akarapon-oaksonsombat/wheel-drive-drawing-robot/README.md

# wheel-drive-drawing-robot
See more in [PSU CoE Project site](https://project.coe.psu.ac.th/projects/6236d625dbcc602776d4a9ff)
or using online tools on [Link](https://drawing-tools-akarapon.web.app/#/)
