akarapon-oaksonsombat/wheel-drive-drawing-robot/wheel_drive_drawing_robot.pdf

หุ่นยนต์วาดภาพขับเคลื่อนด้วยล้อ Wheel drive drawing robot.

อัครพล อักษรสมบัติ 6010110514 พบธรรม วราหกิจ 6110110306

โครงงานวิศวกรรมคอมพิวเตอร์นี้เป็นส่วนหนึ่งของการศึกษาตามหลักสูตร ปริญญาวิศวกรรมศาสตรบัณฑิต สาขาวิชาวิศวกรรมคอมพิวเตอร์ ภาควิชาวิศวกรรมคอมพิวเตอร์คณะวิศวกรรมศาสตร์ มหาวิทยาลัยสงขลานครินทร์
2564

ก

ชื่อโครงงาน | หุ่นยนต์วาดภาพขับเคลื่อนด้วยล้อ
ผู้จัดท า | นายอัครพล อักษรสมบัติ | รหัสนักศึกษา | 6010110514
| นายพบธรรม วราหกิจ | รหัสนักศึกษา | 6110110514
สาขาวิชา | วิศวกรรมคอมพิวเตอร์
ปีการศึกษา | 2564
อาจารย์ที่ปรึกษาโครงงาน | คณะกรรมการสอบ
| ( ผศ.ด ารงค์ เคล้าดี ) | | ( รศ.ดร.มนตรี กาญจนเดชะ )
| | ( ผศ.ดร.วชรินทร์ แก้วอภิชัย )

โครงงานนี้เป็นส่วนหนึ่งของรายวิชาโครงงานวิศวกรรมคอมพิวเตอร์ 1 และ 2 ตามหลักสูตร ปริญญาวิศวกรรมศาสตรบัณฑิต สาขาวิชาวิศวกรรมคอมพิวเตอร์ มหาวิทยาลัยสงขลานครินทร์

| | ( ผศ.ดร.นิคม สุวรรณวร ) หัวหน้าสาขาวิชาวิศวกรรมคอมพิวเตอร์

ข

หนังสือรับรองความเป็นเอกลักษณ์ ข้าพเจ้าผู้ลงนามท้ายนี้ ขอรับรองว่ารายงานฉบับนี้เป็นรายงานที่มีความเป็นเอกลักษณ์ โดยที่ ข้าพเจ้ามิได้มีการคัดลอกมาจากที่ใด เนื้อหาในรายงานทั้งหมดถูกรวบรวมจากการพัฒนาในขั้นตอน ต่าง ๆ ของการจัดท าโครงงาน หากมีส่วนใดที่จ าเป็นต้องน าข้อความจากผลงานของบุคคลอื่นใดที่ ไม ่ใช ่ตัวข้าพเจ้า ข้าพเจ้าได้ท าการอ้างอิงถึงเอกสารเหล ่านั้นไว้อย ่างเหมาะสม และขอรับรองว่า รายงานฉบับนี้ไม่เคยเสนอต่อสถาบันใดมาก่อน

ผู้จัดท า

(นายอัครพล อักษรสมบัติ)
(นายพบธรรม วราหกิจ)

ค

ชื่อโครงงาน | หุ่นยนต์วาดภาพขับเคลื่อนด้วยล้อ
ผู้จัดท า | นายอัครพล อักษรสมบัติ | รหัสนักศึกษา | 6010110514
| นายพบธรรม วราหกิจ | รหัสนักศึกษา | 6110110306
สาขาวิชา | วิศวกรรมคอมพิวเตอร์
ปีการศึกษา | 2564

บทคัดย่อ
โครงงานฉบับนี้มีวัตถุประสงค์เพื ่อออกแบบและพัฒนาหุ ่นยนต์วาดภาพ 2 มิติโดยการ ขับเคลื่อนด้วยล้อ โดยแบ่งออกเป็น 3 ส่วน คือ ระบบกลไก ระบบอิเล็กทรอนิกส์และซอฟต์แวร์และ อัลกอริทึมในการท างานโดยใช้ระบบพิกัดฉากในการสั่งงานวาดภาพและรองรับข้อมูลพิกัดที่แปลงมา จากข้อมูลในรูปแบบ Gcode โดยใช้บอร์ดไมโครคอนโทรลเลอร์ Arduino ในการควบคุมการท างาน ของระบบพร้อมทั้งสามารถจ าลองผลการวาดภาพก่อนวาดจริงผ่านหน้าเว็บแอพพลิเคชันที่พัฒนาขึ้น

ค าส าคัญ ระบบขับเคลื่อนด้วยล้อ หุ่นยนต์วาดภาพสองมิติ การจ าลองการวาดภาพจาก Gcode

ง

Project | 2D Drawing Robotic Arm Driven by Wheels.
Author | Mr.Akarapon Oaksonsombat | Student ID | 6010110514
| Mr.Phobthum Varahakij | Student ID | 6110110306

Major Program Computer Engineering

Academic Year 2021

Abstract
This project aims to design and develop a wheel drive drawing robot. It is divided into 3 parts which are mechanical system, electronic system and software and working algorithm by using scene coordinate system to order drawing and support coordinate data converted from data in Gcode format using a microcontroller board. Arduino to control the operation of the system and can simulate the drawing results before the actual drawing through the web application developed.

Keyword Wheel Drive, Wheel drive drawing Robot, Gcode Drawing Simulator

จ

กิตติกรรมประกาศ

โครงงานเรื่อง “แขนกลวาดภาพ 2 มิติโดยการขับเคลื่อนด้วยล้อ” สามารถด าเนินการบรรลุ ตามเป้าหมายในทุกขั้นตอน ตั้งแต ่การศึกษาหาข้อมูล การด าเนินการต ่าง ๆ รวมไปถึงการจัดท า รายงานฉบับนี้ให้ส าเร็จลุล่วงไปได้ด้วยดี เนื่องจากได้รับความดูแลเอาใจใส่และความเอื้อเฟื้อจาก ผศ.ด ารงค์ เคล้าดี อาจารย์ที่ปรึกษาโครงงาน ซึ่งได้ให้ค าแนะน าและข้อคิดเห็นต่าง ๆ รวมถึงแก้ไข ปัญหาที่เกิดขึ้นในระหว่างการด าเนินงาน และต้องขอขอบคุณไปถึง รศ.ดร.มนตรี กาญจนะเดชะ, ดร.วชรินทร์แก้วอภิชัย, ผศ.ดร.ทวีศักดิ์ เรืองพีระกุล คณะกรรมการสอบที่ให้ข้อเสนอแนะเพื ่อให้ ผู้จัดท าน ามาปรับปรุงแก้ไข
ขอขอบคุณคณะวิศวกรรมศาสตร์ มหาวิทยาลัยสงขลานครินทร์ที่ช่วยสนับสนุนเงินเพื่อใช้ใน การท าโครงงาน

อัครพล อักษรสมบัติ
พบธรรม วราหกิจ

ฉ

สารบัญ
บทคัดย่อ | ค
Abstract | ง
กิตติกรรมประกาศ | จ
สารบัญ | ฉ
รายการภาพประกอบ | ฌ
รายการตาราง | ญ

ช

ซ

ฌ

รายการภาพประกอบ

ญ

รูปที่ 4-26 ค าสั่งที่ใช้ในการรับข้อมูลจากการป้อนจาก Analog Buttonแล้วแสดงผลในจอ LCD....32

รูปที่ 4-30 ภาพถ่ายการแสดงผลตามฟังก์ชันแสดงผลหน้าจอควบคุมการท างานแบบก าหนดเอง....35

รายการตาราง

ฎ

บทที่1 บทน า

### 1.1 ที่มาและความส าคัญ

หุ่นยนต์เป็นหุ่นยนต์ชนิดหนึ่งที่น ามาใช้งานแทนแรงงานมนุษย์โดยมักถูกใช้ในงานที่ต้องท าซ ้า ๆ และต้องการความแม่นย าสูง ซึ่งต้นทุนในการประดิษฐ์หุ ่นยนต์นั้นมีราคาค่อนข้างสูงและเป็นที่ ต้องการอย่างมากในอุตสาหกรรมการผลิตต่าง ๆ ในปัจจุบัน
หุ ่นยนต์วาดภาพเป็นหนึ ่งรูปแบบของหุ ่นยนต์ที ่ถูกออกแบบมาให้มีความสามารถแบบ เฉพาะเจาะจงในการวาดภาพและสามารถใช้ประกอบการศึกษากลไกการขับเคลื่อนของหุ่นยนต์ผ่าน การแสดงออกในรูปแบบของลายเส้นที่เป็นผลลัพธ์จากการท างานของหุ่นยนต์อีกด้วย การใช้ระบบขับเคลื่อนด้วยล้อท าให้ชิ้นงานมีความสามารถในการเคลื่อนหรือหมุนไปตามทิศ ต่าง ๆ ได้ซึ่งท าให้สามารถลดต้นทุนในการประดิษฐ์หุ่นยนต์วาดภาพโดยยังคงความสามารถในการ ท างานไว้ได้อย่างครบถ้วน
ผู้จัดท าจึงยกประเด็นนี้มาเป็นหัวข้อในการท าโครงงานเพื่อออกแบบและพัฒนาหุ่นยนต์วาด ภาพสองมิติที่ใช้กลไกการขับเคลื่อนด้วยล้อส าหรับใช้ในการศึกษาอัลกอริทึมและกลไกการท างานของ หุ่นยนต์รูปแบบนี้ในอนาคตโดยมีหลักการในการพัฒนาคือตัวชิ้นงานจะต้องมีความเรียบง่ายและใช้ ต้นทุนต ่า

### 1.2 วัตถุประสงค์

1. เพื่อออกแบบหุ่นยนต์วาดภาพสองมิติที่ใช้กลไกการขับเคลื่อนด้วยล้อ
2. สร้างองค์ความรู้พื้นฐานเกี่ยวกับระบบขับเคลื่อนในสองมิติด้วยล้อ

### 1.3 ประโยชน์ที่คาดว่าจะได้รับ

1. ได้หุ่นยนต์ขับเคลื่อนในสองมิติด้วยล้ออย่างง่ายและมีต้นทุนในการประดิษฐ์ที่ถูกและง่าย ต่อการพัฒนาต่อยอด
2. ได้องค์ความรู้พื้นฐานเกี่ยวกับระบบขับเคลื่อนด้วยล้อที่ควบคุมด้วยไมโครคอนโทรลเลอร์
3. ผลงานที่ถูกสร้างและพัฒนาขึ้นนี้สามารถใช้เป็นต้นแบบในการศึกษาและพัฒนาต่อยอด เพื่อเป็นประโยชน์ในอนาคตได้

### 1.4 ขอบเขตของโครงงาน

1. หุ่นยนต์ที่พัฒนาจะวาดชิ้นงานแบบสองมิติโดยใช้การขับเคลื่อนด้วยล้อ
2. หุ่นยนต์ที่พัฒนาจะสามารถวาดภาพในพื้นที่ขนาดอย่างน้อย 4 ตารางเซนติเมตร

### 1.5 ขั้นตอนการด าเนินงาน

1. ศึกษาทฤษฎีเกี่ยวกับแขนหุ่นยนต์
2. ศึกษาการท างานและการใช้งาน Stepping Motor
3. ศึกษาระบบอิเล็กทรอนิกส์ด้านการแสดงผลและการเชื่อมต่อผู้ใช้
4. ศึกษาอัลกอริทึมและการควบคุมของระบบ
5. ออกแบบโครงสร้างทางกลไก
6. ออกแบบระบบอิเล็กทรอนิกส์
7. ออกแบบอัลกอริทึมและซอฟต์แวร์ควบคุมระบบ
8. ทดสอบการใช้งานอุปกรณ์ฮาร์ดแวร์
9. พัฒนาซอฟต์แวร์ที่ใช้ในการควบคุมการท างานแต่ละส่วน
10. น าซอฟต์แวร์ที่พัฒนามาประกอบเข้ากันเป็นระบบ
11. ทดสอบการท างานขั้นต้นของระบบ
12. ทดสอบการท างานจริงของทั้งระบบ
13. ท าการปรับปรุงแก้ไขข้อผิดพลาดที่ได้จากการทดสอบ
14. จัดท ารายงานฉบับสมบูรณ์

บทที่2 ทฤษฎีและหลักการ

เพื่อให้การด าเนินงานบรรลุตามวัตถุประสงค์ผู้จัดท าจึงได้ท าการศึกษาทฤษฎีและหลักการต่าง ๆ เพื่อเป็นองค์ความรู้ประกอบการพัฒนาระบบซึ่งแบ่งศึกษาออกเป็นสามส่วนคือ ส่วนระบบทางกลไก ส่วนระบบอิเล็กทรอนิกส์และส่วนซอฟต์แวร์และอัลกอริทึม
ส ่วนระบบทางกลไกได้ท าการศึกษากลไกของแขนหุ ่นยนต์ [1] ระบบขับเคลื ่อนด้วยล้อและ มอเตอร์ซึ่งมีรายละเอียดการศึกษาดังนี้

### 2.1 แขนหุ่นยนต์

แขนหุ่นยนต์[2] เป็นชนิดของหุ่นยนต์ที่มีการเคลื่อนไหวในแบบที่เป็นไปในลักษณะเชิงกลไกที่มัก ถูกใช้ส าหรับหยิบ จับ เคลื่อนย้ายสิ่งของได้ในพื้นที่การท างาน หรือ Working Space ที่ก าหนดไว้ เท่านั้น โดยมีองค์ประกอบดังต่อไปนี้

### 2.1.1 Degree of Freedom

Degree of Freedom (DoF) หรือ องศาอิสระ คือ จ านวนแกนหรือทิศทางที ่แขนหุ ่นยนต์ สามารถเคลื ่อนไหวได้ ซึ ่งแบ ่งการเรียกตามลักษณะความสามารถในการเคลื ่อนไหว คือ การ เคลื่อนไหวในแนวระนาบและไม่สามารถปรับมุมการหมุนได้ เรียกว่า “2 Degree of Freedom” การ เคลื ่อนไหวในสามมิติแต ่ไม ่สามารถปรับมุมการเอียงของปลายแขนได้ เรียกว ่า “3 Degree of Freedom” และการเคลื่อนไหวในสามมิติและสามารถควบคุมการหมุนของปลายแขนได้รอบทิศทาง ซึ่งเรียกว่า “6 Degree of Freedom”
ส าหรับหุ่นยนต์ที่มีมากกว่า 6 Degree of Freedom คือ หุ่นยนต์ที่สามารถเคลื่อนปลายแขนไป ยังต าแหน่งใด ๆ ในสามมิติและสามารถควบคุมการหมุนของปลายแขนได้มากกว่า 1 ท่าทางเพื่อให้ได้ ต าแหน่งปลายแขนอยู่ในต าแหน่งเดิม เช่น กรณีของแขนมนุษย์ทั่วไปซึ่งจะมี 7 Degree of Freedom ซึ่งสามารถขยับแขนได้โดยที่มืออยู่ในต าแหน่งเดิม

### 2.1.2 Working Space

Working Space หรือ พื้นที่การท างาน คือ พื้นที่ที่ปลายของแขนหุ่นยนต์สามารถเคลื่อนที่ไปได้

### 2.1.3 Link

Link หรือ ลิงค์คือ โครงสร้างแขนแต่ละท่อนของแขนหุ่นยนต์

### 2.1.4 Base

Base หรือ ฐาน คือ ลิงค์ชั้นแรกสุดที่ใช้ยึดแขนหุ่นยนต์ไว้กับพื้น

### 2.1.5 Joint

Joint หรือ ข้อต่อ คือ ส่วนเชื่อมต่อระหว่างแต่ละลิงค์ของแขนหุ่นยนต์แบ่งเป็น 2 ประเภท คือ
1. Active Joint
Active Joint คือ ข้อต่อที่มีต้นก าลังติดตั้งอยู่ท าให้สามารถควบคุมการเคลื่อนที่ได้
2. Passive Joint
Passive Joint คือ ข้อต่อที่ไม่มีต้นก าลังติดตั้งอยู่ท าให้ไม่สามารถควบคุมการเคลื่อนที่ได้ โดยการเคลื่อนที่ของ Passive Joint จะเป็นไปตามการเคลื่อนที่ของข้อต่ออื่น ๆ ที่เชื่อมโยง กันและแบ่งออกตามรูปแบบการเคลื่อนที่ได้ 4 รูปแบบ คือ
- Revolute Joint คือ ข้อต่อที่หมุนได้ (1 DoF)
- Prismatic Joint คือ ข้อต่อที่เคลื่อนที่เข้า-ออกเป็นแนวเส้น (1 DoF)
- Screw Joint คือ ข้อต่อที่หมุนและเคลื่อนที่เข้า-ออกสัมพันธ์กัน (1 DoF)
- Spherical Joint คือ ข้อต่อที่หมุนได้รอบ (2 DoF)

### 2.1.6 Wrist

Wrist คือ ข้อต่อที่ไม่ท าให้เกิดการเคลื่อนที่ในสามมิติแต่ท าให้เกิดการหมุนมักไว้เป็นข้อต่อสุดท้าย ที่ปลายแขน

### 2.1.7 End Effector

End-Effector คือ อุปกรณ์ที่ติดตั้งไว้ที่ปลายแขนเพื่อใช้ท างาน โดยอาจเป็นมือจับ ตัวดูด สุญญากาศ สว่าน เป็นต้น

แขนหุ่นยนต์ที่ใช้ในอุตสาหกรรมแบ่งออกเป็น 5 ประเภทตามลักษณะการเคลื่อนไหวดังตารางที่ 2-1Error! Reference source not found.

5

ตารางที่ 2-1 ประเภทของแขนหุ่นยนต์

ประเภทของแขนหุ่นยนต์[3] | ข้อดี - ข้อเสีย | การประยุกต์ใช้งาน
Cartesian Robot | ข้อดี เคลื่อนที่เป็นแนวเส้นตรงทั้ง 3 มิติสามารถท าความเข้าใจการเคลื่อนที่ได้ ง่ายและมีส่วนประกอบน้อยอีกทั้งโครงสร้างยังมั่นคงตลอดการเคลื่อนที่ ข้อเสีย ต้องการพื้นที่ติดตั้งมากและบริเวณที่หุ ่นยนต์เข้าไปท างานได้จะต้องมี ขนาดเล็กกว่าขนาดของตัวหุ่นยนต์อีกทั้งไม่สามารถเข้าถึงวัตถุจากทิศทาง ข้างใต้ได้และยังแกนแบบเชิงเส้นป้องกันฝุ่นและของเหลวได้ยากอีกด้วย

เนื่องจากโครงสร้างมีความแข็งแรงตลอดแนวการ เคลื่อนที่ ดังนั้นจึงเหมาะกับงานเคลื่อนย้ายของหนัก ๆ หรือเรียกว ่างาน Pick-and-Place เช ่นใช้โหลด ชิ้นงานเข้าเครื่องจักร (Machine loading) ใช้จัดเก็บ ชิ้นงาน (Stacking) นอกจากนี้ยังสามารถใช้ในงาน ประกอบ (Assembly) ที่ไม่ต้องการเข้าถึงในลักษณะ ที่มีมุมหมุน เช่น ประกอบอุปกรณ์อิเล็กทรอนิกส์ และ งาน Test ต่าง ๆ

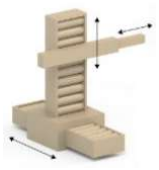
[picture p1: figure]

Cylindrical Robot | ข้อดี ตัวหุ่นยนต์มีส่วนประกอบไม่ซับซ้อนและมีการเคลื่อนที่สามารถเข้าใจได้ ง่าย สามารถเข้าถึงเครื่องจักรที่มีการเปิด-ปิด หรือเข้าไปในบริเวณที่เป็น ช่องหรือโพรงได้ง่าย (Loading) เช่น การโหลดชิ้นงานเข้าเครื่อง CNC

โดยทั ่วไปจะใช้ในการหยิบยกชิ้นงาน หรือ ป้อนชิ้นงานเข้าเครื่องจักร เพราะสามารถเคลื่อนที่เข้า ออกบริเวณที่เป็นช่องโพรงเล็ก ๆ ได้สะดวก

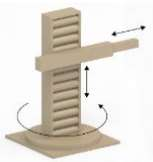
[picture p2: figure]

6

ประเภทของแขนหุ่นยนต์[3] | ข้อดี - ข้อเสีย | การประยุกต์ใช้งาน
| ข้อเสีย มีพื้นที่ท างานจ ากัดและยังแกนแบบเชิงเส้นป้องกันฝุ่นและของเหลวได้ ยากอีกด้วย

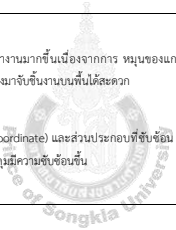
[picture p3: figure]

Spherical Robot | ข้อดี หุ ่นยนต์มีปริมาตรการท างานมากขึ้นเนื ่องจากการ หมุนของแกนที ่ 2 (ไหล่) และสามารถที่จะก้มลงมาจับชิ้นงานบนพื้นได้สะดวก ข้อเสีย หุ่นยนต์มีระบบพิกัด (Coordinate) และส่วนประกอบที่ซับซ้อน ท าให้ การเคลื่อนที่และระบบควบคุมมีความซับซ้อนขึ้น

ใช้ในงานที่มีการเคลื่อนที่ในแนวตั้ง (Vertical) เพียง เล็กน้อย เช่น การโหลดชิ้นงานเข้าออกจากเครื ่องปั๊ม (Press) หรืออาจจะใช้งานเชื่อมจุด (Spot Welding)

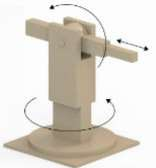
[picture p4: figure]

7

ประเภทของแขนหุ่นยนต์[3] | ข้อดี - ข้อเสีย | การประยุกต์ใช้งาน
SCARA Robot | ข้อดี หุ่นยนต์สามารถเคลื ่อนที ่ในแนวระนาบและขึ้นลงได้รวดเร็วด้วยความ แม่นย าสูง ข้อเสีย หุ่นยนต์มีพื้นที่ท างานจ ากัดและไม่สามารถหมุน (rotation) ในลักษณะ มุมต่าง ๆ ได้อีกทั้งสามารถยกน ้าหนัก (Payload) ได้ไม่มากนัก | เนื่องจากการเคลื ่อนที่ในแนวระนาบและขึ้นลงได้ รวดเร็วจึงเหมาะกับ งานประกอบชิ้นส ่วนทาง อิเล็กทรอนิกส์ซึ ่ง ต้องการความรวดเร็วและการ เคลื่อนที่ก็ไม่ต้องการ การหมุนมากนัก แต่จะไม่เหมาะ กับงาน

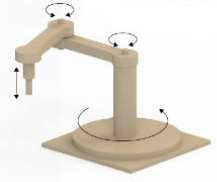
[picture p5: figure]

Articulated Arm
(Revolute)

ข้อดี
หุ่นยนต์สามารถเคลื ่อนที ่ในแนวระนาบและขึ้นลงได้รวดเร็วด้วยความ แม่นย าสูง
ข้อเสีย
หุ่นยนต์มีพื้นที่ท างานจ ากัดและไม่สามารถหมุน (rotation)ในลักษณะมุม ต่าง ๆ ได้อีกทั้งสามารถยกน ้าหนัก (Payload) ได้ไม่มากนัก

เนื่องจากการเคลื ่อนที่ในแนวระนาบและขึ้นลงได้ รวดเร็วจึงเหมาะกับ งานประกอบชิ้นส ่วนทาง อิเล็กทรอนิกส์ซึ ่ง ต้องการความรวดเร็วและการ เคลื่อนที่ก็ไม่ต้องการ การหมุนมากนัก แต่จะไม่เหมาะ กับงานประกอบชิ้นส ่วนทางกล (Mechanical part) ซ ึ ่งส ่ วนใหญ ่ก า รป ร ะกอบจ ะอ าศัย ก า รหมุน (Rotation) ในลักษณะมุมต ่าง ๆ นอกจากนี้ SCARA Robot ยังเหมาะกับงานตรวจสอบ (Inspection) งาน บรรจุภัณฑ์ (Packaging)

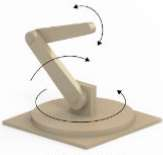
[picture p6: figure]

### 2.2 ระบบวาดภาพโดยใช้กลไกการขับเคลื่อนด้วยล้อ [1]

ผู้จัดท าได้ท าการศึกษาระบบวาดภาพโดยใช้กลไกการขับเคลื่อนด้วยล้อใน 4 รูปแบบดังนี้

### 2.2.1 ระบบวาดภาพโดยใช้กลไกการขับเคลื่อนด้วยล้อแบบคว ่า

ระบบวาดภาพโดยใช้กลไกการขับเคลื ่อนด้วยล้อแบบคว ่าจะเป็นการน าตัวขับเคลื ่อนวางทับ ชิ้นงานโดยจะมีกลไกการลดแรงเสียดทานอยู่ล่างชิ้นงานเพื่อให้ชิ้นงานสามารถเคลื่อนที่ได้

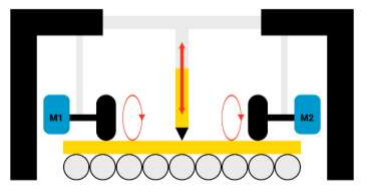
[picture p7: figure]

รูปที่ 2-1 ระบบวาดภาพโดยใช้กลไกการขับเคลื่อนด้วยล้อแบบคว ่า

### 2.2.2 ระบบวาดภาพโดยใช้กลไกการขับเคลื่อนด้วยล้อแบบหงาย

ระบบวาดภาพโดยใช้กลไกการขับเคลื ่อนด้วยล้อแบบหงาย เป็นการน าแผ ่นเรียบวางในแนว ระนาบไว้บนล้อที่ขับเคลื่อนด้วยมอเตอร์ ซึ่งอาจมีการติดตั้งล้อกลมในจุดต่าง ๆ ใต้แผ่นเรียบส าหรับ การช่วยพยุงแผ่นเรียบตามความเหมาะสม

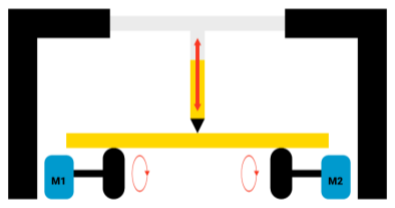
[picture p8: figure]

รูปที่ 2-2 ระบบวาดภาพโดยใช้กลไกการขับเคลื่อนด้วยล้อแบบหงาย

### 2.2.3 ระบบวาดภาพโดยใช้กลไกการขับเคลื่อนด้วยยานยนต์

ระบบวาดภาพโดยใช้กลไกการขับเคลื่อนด้วยยานยนต์จะอยู่ในรูปแบบคล้ายกับรถที่รวมอุปกรณ์ ส าหรับการท างานต่าง ๆ ไว้ โดยชิ้นงานจะอยู่กับที่

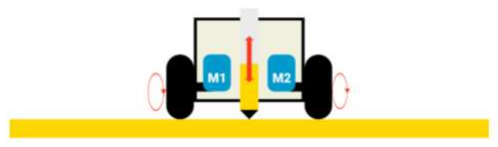
[picture p9: figure]

รูปที่ 2-3 ระบบวาดภาพโดยใช้กลไกการขับเคลื่อนด้วยยานยนต์

### 2.2.4 ระบบวาดภาพโดยใช้กลไกการขับเคลื่อนด้วยล้อแนวดิ่ง

ระบบวาดภาพโดยใช้กลไกการขับเคลื่อนด้วยล้อแนวดิ่งจะใช้หลักการเดียวกันกับระบบวาดภาพ โดยใช้กลไกการขับเคลื่อนด้วยยานยนต์แต่ตัวรถจะถูกติดตั้งไว้ที่ปลายแขนหุ่นยนต์และถูกกดไว้ให้ติด กับผนัง โดยการท างานของแขนหุ่นยนต์นั้นจะมีหน้าที่เพียงกดและพยุงให้รถอยู่ติดกับผนัง

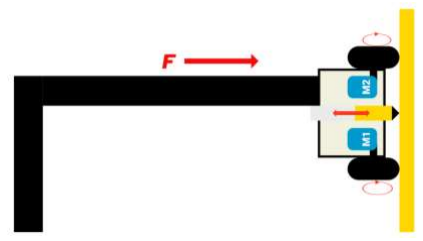
[picture p10: figure]

รูปที่ 2-4 ระบบวาดภาพโดยใช้กลไกการขับเคลื่อนด้วยล้อแนวแนวดิ่ง

### 2.3 มอเตอร์

มอเตอร์ที ่ใช้ในการท าโครงงานนี้มี 2 ชนิด คือ Stepping Motor และ Servo Motor ซึ ่งมี รายละเอียดการท างานดังนี้

### 2.3.1 Stepping Motor

Stepping Motor [4] เป็นมอเตอร์ไฟฟ้าที ่ขับเคลื ่อนด้วยสัญญาณแบบพัลส์โดยจะต้องจ ่าย สัญญาณพัลส์เป็นสเต็ปโดยขนาดของแต่ละสเต็ปจะขึ้นอยู่กับโครงสร้างของมอเตอร์ซึ่งสามารถหมุนได้ ทั้งสองทิศทางและไม่มีการจ ากัดรอบการหมุน

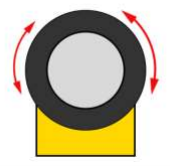
[picture p11: figure]

รูปที่ 2-5 ทิศทางการหมุนของ Stepping Motor การควบคุม Stepping Motor แบ ่งออกเป็นสามรูปแบบ คือ Full-Step 1 Phase Full-
Step 2 Phase และ Half-Step โดยมีลักษณะการจ่ายสัญญาณดังError! Reference source not found. ตารางที่ 2-3 และตารางที่ 2-4 ตามล าดับ

ตารางที่ 2-2 การควบคุม Stepping Motor ด้วยสัญญาณพัลส์แบบ Full-Step 1 Phase

สเต็ปที่ | เฟสที่ 1 | เฟสที่ 2 | เฟสที่ 3 | เฟสที่ 4
1 | 1 | 0 | 0 | 0
2 | 0 | 1 | 0 | 0
3 | 0 | 0 | 1 | 0
4 | 0 | 0 | 0 | 1

ตารางที่ 2-3 การควบคุม Stepping Motor ด้วยสัญญานพัลส์แบบ Full-Step 2 Phase

สเต็ปที่ | เฟสที่ 1 | เฟสที่ 2 | เฟสที่ 3 | เฟสที่ 4
1 | 1 | 1 | 0 | 0
2 | 0 | 1 | 1 | 0
3 | 0 | 0 | 1 | 1
4 | 1 | 0 | 0 | 1

ตารางที่ 2-4 การควบคุม Stepping Motor ด้วยสัญญาณพัลส์แบบ Half-Step

สเต็ปที่ | เฟสที่ 1 | เฟสที่ 2 | เฟสที่ 3 | เฟสที่ 4
1 | 1 | 0 | 0 | 0
2 | 1 | 1 | 0 | 0
3 | 0 | 1 | 0 | 0
4 | 0 | 1 | 1 | 0
5 | 0 | 0 | 1 | 0
6 | 0 | 0 | 1 | 1
7 | 0 | 0 | 0 | 1
8 | 1 | 0 | 0 | 1

ในการใช้งานจริงบอร์ดไมโครคอนโทรลเลอร์จะจ่ายไฟฟ้าได้ไม่เพียงพอในการขับการท างาน ของ Stepping Motor จึงมีความจ าเป็นในการใช้ Stepping Motor Driver ในการช่วยขับไฟฟ้าให้ เพียงพอส าหรับการท างานของ Stepping Motor

### 2.3.2 RC Servo Motor

RC Servo Motor เป็นมอเตอร์ที่สามารถรับค่าองศาเพื่อให้มอเตอร์หมุนไปยังองศาที่ก าหนดได้ ระหว่าง 0 ถึง 180 องศาและไม่สามารถหมุนเกินขอบเขตที่จ ากัดไว้ได้

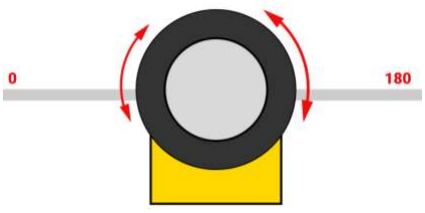
[picture p12: figure]

รูปที่ 2-6 ทิศทางการหมุนของ RC Servo Motor การควบคุมการท างานของ RC Servo Motor สามารถท าได้ง่ายผ่านไลบรารี Servo.h ซึ่งมี ให้ใช้งานใน Arduino IDE และจ่ายสัญญาณควบคุมโดยใช้ช่องเชื่อมต่อเดียว

ส่วนระบบอิเล็กทรอนิกส์ได้ท าการศึกษาการใช้งานอุปกรณ์ส าหรับการประดิษฐ์กล่องควบคุม และอุปกรณ์การควบคุมการท างานของหุ่นยนต์ซึ่งมีรายละเอียดการศึกษาดังนี้

### 2.4 Stepping Motor Driver

Stepping Motor Driver [5] ใช้ส าหรับต่อแหล ่งจ ่ายไฟและรับสัญญาณควบคุมที่มาจาก ไมโครคอนโทรลเลอร์เพื ่อควบคุมการท างานของมอเตอร์ ซึ ่งสามารถจ ่ายไฟฟ้าไปยังมอเตอร์ได้ มากกว่าไมโครคอนโทรลเลอร์

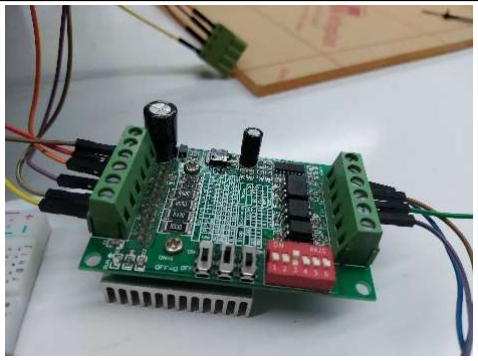
[picture p13: figure]

รูปที่ 2-7 Stepping Motor Driver

### 2.5 Tracking Sensor

โมดูลอ่านค่าสะท้อนกลับของแสง ใช้ไฟ 3.3-5V เหมาะส าหรับใช้กับบอร์ด Arduino โดย สามารถให้เอาต์พุตได้2 รูปแบบคือ แบบดิจิตอลสามารถปรับค่าที่ต้องการได้ เมื่อค่าที่อ่านได้ถึงระดับ ที่ต้องการโมดูลจะส ่งออกค ่าลอจิก 1 แต่ถ้าหากยังไม ่ถึงระดับโมดูลจะส ่งค ่าลอจิก 0 และแบบ อนาล็อกสามารถอ่านค่าได้เป็นตัวเลขระหว่าง 0-1023 ซึ่งอยู่ในรูปแบบของแรงดันไฟฟ้าในช่วง 0-5V

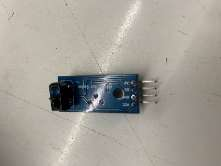
[picture p14: figure]
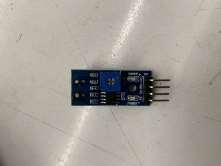
[picture p15: figure]

รูปที่ 2-8 Tracking Sensor

ส่วนซอฟต์แวร์และอัลกอริทึมได้ท าการศึกษาสมการส าหรับการค านวณค่าที่เกี่ยวข้องต่าง ๆ ในการท าโครงงานซึ่งมีรายละเอียดการศึกษาดังนี้

### 2.6 สมการที่เกี่ยวข้องกับการท างานของมอเตอร์

### 2.6.1 Linear movement equation

1. forward kinematics

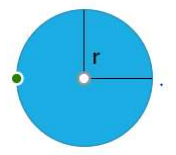
[picture p16: figure]

R = รัศมีของเฟืองมอเตอร์ (mm)
m.r. = จ านวนstep ต่อรอบ (สเต็ปต่อรอบ) d = ระยะทางที่เคลื่อนที่(mm)
2. inverse kinematics

R = รัศมีของเฟืองมอเตอร์ (mm)
m.r. = จ านวนstep ต่อรอบ (สเต็ปต่อรอบ) d = ระยะทางที่เคลื่อนที่(mm)

d = f(motorstep)

d =

(2πR)
m. r.

× motorstep

motorstep = f(d)

motorstep =

m. r.
2πR

× d

### 2.6.2 Rotate movement equation

1. Forward kinematics

*เมื่อต้องการให้จุดศูนย์กลางเป็นจุดหมุน motorstep0 = -motorstep1 θ= มุม (องศา)
R = รัศมีของล้อ (mm)
m.r. = จ านวนstep ต่อรอบ (สเต็ปต่อรอบ)
l = ระยะห่างระหว่างล้อ (mm)
2. inverse kinematics

*เมื่อต้องการให้จุดศูนย์กลางเป็นจุดหมุน motorstep0 = -motorstep1 θ = มุม (องศา)
R = รัศมีของล้อ (mm)
m.r. = จ านวนstep ต่อรอบ (สเต็ปต่อรอบ)
l = ระยะห่างระหว่างล้อ (mm)

θ = f(motorstep0, motorstep1)

θ =

180l
R × m. r.

motorstep

motorstep = f(θ)

motorstep =

R × m. r.
180l

θ

บทที่3 วิธีการด าเนินงาน

ในการออกแบบและพัฒนาอุปกรณ์ฮาร์ดแวร์และซอฟต์แวร์ถูกแบ่งออกเป็น 3 ส่วน คือ ระบบ ทางกลไก ระบบอิเล็กทรอนิกส์และระบบอัลกอริทึม ซึ่งมีรายละเอียดภาพรวมในการด าเนินงานดังนี้

### 3.1 ระบบทางกลไก

ระบบทางกลไกประกอบด้วยแขนหุ่นยนต์ที่ขยับได้เฉพาะปลายแขนในทิศขึ้นลงซึ่งถูกควบคุม ด้วย RC Servo Motor และส่วนแผ่นเรียบจะใช้เป็นวัสดุเป็นแผ่นอะคริลิกส าหรับใช้ติดชิ้นงานโดยจะ วางไว้บนล้อทั้งสองของอุปกรณ์ซึ่งถูกควบคุมผ่าน Stepping Motor ซึ่งมีรายละเอียดดังError! Reference source not found.

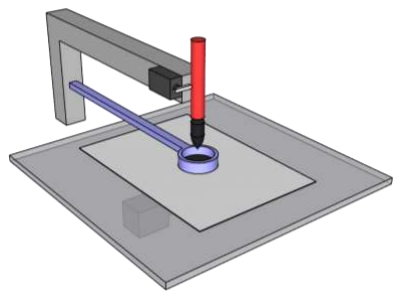
[picture p17: figure]
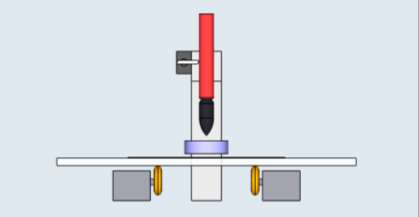
[picture p18: figure]

รูปที่ 3-1 ภาพรวมของระบบทางกลไกของโครงงาน

### 3.1.1 ชุดทดสอบกลไกเบื้องต้น

เพื่อให้การทดสอบ ออกแบบและพัฒนาเป็นไปได้อย่างรวดเร็วผู้จัดท าจึงได้จัดท าชุดทดสอบ กลไกเบื้องต้นเพื่อทดสอบการท างานเบื้องต้นของอุปกรณ์ฮาร์ดแวร์และอ านวยความสะดวกในการ พัฒนาอัลกอริทึมในการควบคุมการท างานของอุปกรณ์ในระหว่างการสั่งซื้อและประกอบชิ้นส่วนทาง กลไกซึ่งอาจใช้เวลานานโดยมีรายละเอียดดังError! Reference source not found.

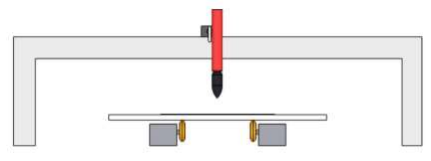
[picture p19: figure]

รูปที่ 3-2 ชุดทดสอบกลไกเบื้องต้น ชุดทดสอบกลไกเบื้องต้นถูกออกแบบเพื่อใช้ส าหรับการทดสอบการท างานของ Stepping Motor และทดสอบอัลกอริทึมในการควบคุมการท างานของ Stepping Motor ที่ใช้ในการหมุน ขยับ แผ่นอะคริลิกและทดสอบการใช้งานกล่องควบคุมการท างานของระบบซึ่งใช้ในการรับค าสั่งจากผู้ใช้ และสั่งการท างานของระบบ

### 3.2 ระบบอิเล็กทรอนิกส์

เป็นส่วนฮาร์ดแวร์ที่ใช้ในการควบคุมการท างานของระบบโดยเริ่มต้นตั้งแต่การรับข้อมูลจาก ผู้ใช้งานไปจนถึงการควบคุมการท างานของมอเตอร์โดยการใช้บอร์ด Arduino รุ่น ATMega 2560 เป็นตัวกลางในการควบคุมการท างานและรับข้อมูลจากคีย์แพดและปุ่มกดแล้วจึงน าไปประมวลผล และแสดงผลในหน้าจอ LCD และสั่งการท างานมอเตอร์ต่อไปดังError! Reference source not found.

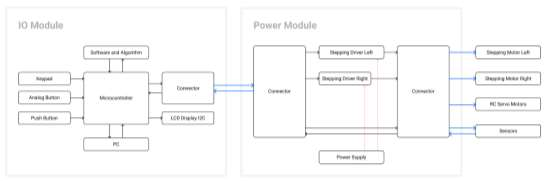
[picture p20: figure]

รูปที่ 3-3 ภาพรวมระบบอิเล็กทรอนิกส์

ผู้จัดท าได้ประดิษฐ์กล่องส าหรับจ่ายพลังงานไฟฟ้าและควบคุมระบบขับเคลื่อนที่ประกอบด้วย แหล่งจ่ายพลังงานให้อุปกรณ์ทั้งหมดในระบบและอุปกรณ์ส าหรับควบคุมการขับเคลื่อนของมอเตอร์ อีกทั้งยังเป็นทางผ่านในการเชื่อมต่อจากกล่องควบคุมไปยังอุปกรณ์ต่าง ๆ ดังError! Reference source not found.

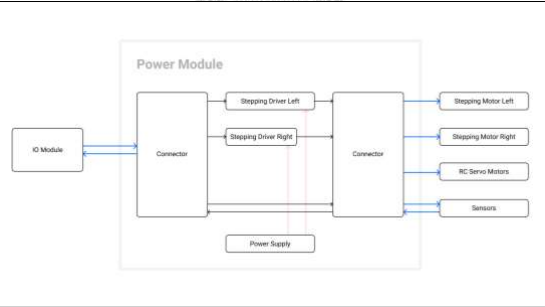
[picture p21: figure]

รูปที่ 3-4 ภาพรวมกล่องจ่ายไฟฟ้าและควบคุมระบบขับเคลื่อน

### 3.3 ซอฟต์แวร์และอัลกอริทึม

### 3.3.1 การค านวณจ านวนสเต็ปต่อรอบในการค านวณการหมุนของมอเตอร์

จากการที่เลือกใช้มอเตอร์แบบฮาล์ฟสเต็ป และมีการทดรอบแบบ 1 ต่อ 2 ท าให้จ านวนสเต็ปที่ ต้องใช้ในการหมุนให้ครบ 1 รอบนั้นใช้ 1500 สเต็ป และการที่ล้อตัวอย่างมีขนาดเส้นผ่านศูนย์กลาง 63 มิลลิเมตร และห่างกัน 150 มิลลิเมตรจะท าให้เกิดผลดังนี้

### 1. การเคลื่อนที่แบบ linear

หากต้องการที่เคลื่อนที่ไป 20 มิลลิเมตรจะต้องเคลื่อนที่

motorsteps =

distance × 1500
πd | =

20 × 1500
πd = 151 steps

หากหมุนไป 1000 สเต็ป จะได้ระยะทาง

distance =

πd(motorsteps)
1500 =

π(63)(1000)
1500 = 131 mm.

### 2. การเคลื่อนที่แบบ rotate

หากต้องการที่เคลื่อนที่ไป 20 องศาจะต้องเคลื่อนที่

motorsteps =

π × 150 × Ø
360 /(distance per step)

=

π × 150 × 180
360 / (

π(63)
1500 ) = 198 steps

หากหมุนไป 100 สเต็ปจะได้องศา

Ø =

motorsteps × (distance per step) × 360 π × 150

=

100 × (

π(63)
1500 ) × 360
π × 150 | = 10.08 องศา

### 3.3.1 ลักษณะการหมุนของแผ่นเรียบบนล้อ

เมื่อหมุนแผ่นเรียบที่ยึดชิ้นงานไว้จะเปรียบเหมือนมีวงกลมอยู่ระหว่างล้อที่ห่างกันในระยะ L โดย จะเกิดวงกลมเสมือนทีมีรัศมี L/2 จะได้ว่าวงกลมด้านในมีเส้นรอบวง πL หากล้อมีรัศมี R หากหมุน ล้อไป 1 รอบ แผ่นเรียบจะหมุนไปทั้งหมด πL/2πR รอบ หรือ L/2R รอบ

รูปที่ 3-5 ลักษณะการหมุนของแผ่นเรียบบนล้อ

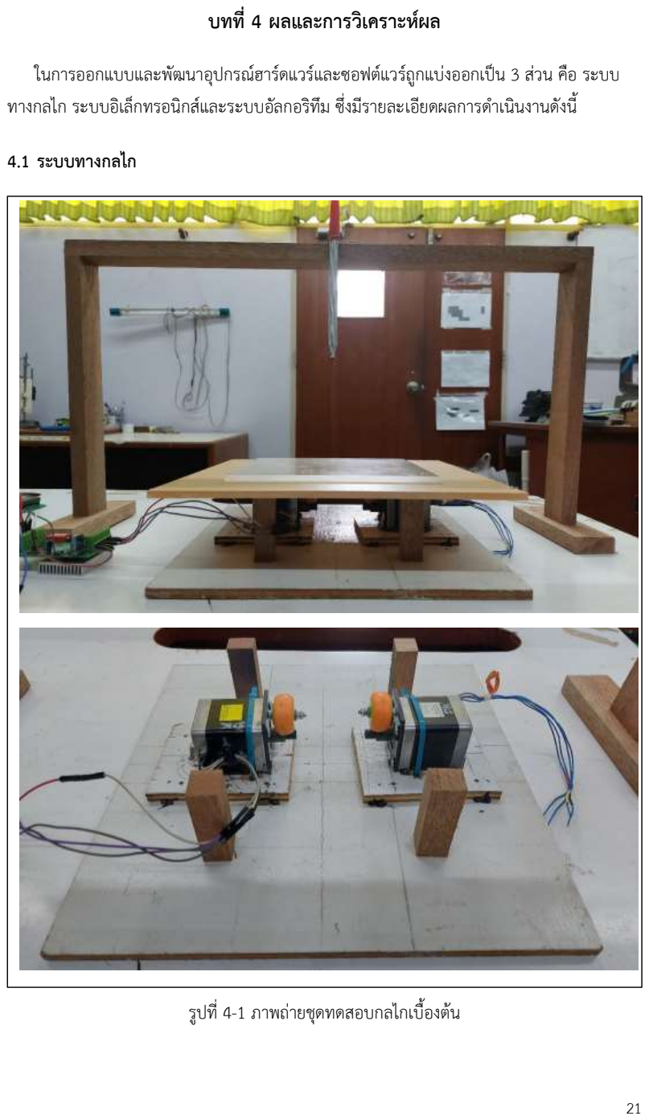
[picture p22: page 33]

บทที่4 ผลและการวิเคราะห์ผล

ในการออกแบบและพัฒนาอุปกรณ์ฮาร์ดแวร์และซอฟต์แวร์ถูกแบ่งออกเป็น 3 ส่วน คือ ระบบ ทางกลไก ระบบอิเล็กทรอนิกส์และระบบอัลกอริทึม ซึ่งมีรายละเอียดผลการด าเนินงานดังนี้

### 4.1 ระบบทางกลไก

รูปที่ 4-1 ภาพถ่ายชุดทดสอบกลไกเบื้องต้น

### 4.1.1 ชุดทดสอบกลไกเบื้องต้นรุ่นปรับปรุง

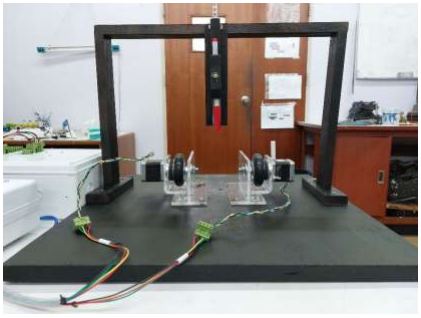
[picture p23: figure]

รูปที่ 4-2 ภาพถ่ายชุดทดสอบกลไกเบื้องต้นรุ่นปรับปรุง

### 4.1.2 กลไกการทดเพื่อเพิ่มความละเอียด

ในการออกแบบและพัฒนาเพื่อความละเอียดที่มากขึ้นได้มีการออกแบบการทดรอบ โดยการ ต่อพูลเลย์และสายพานและขับเคลื่อนด้วยการใช้แรงเสียดทาน พร้อมทั้งมีการเพิ่มขาที่ช่วยพยุงและ ติดลูกปืนเพื่อลดแรงต้านดังรูปที่ 4-3 กลไกการทดที่ออกแบบส าหรับการใช้งานในล้อขับเคลื่อน

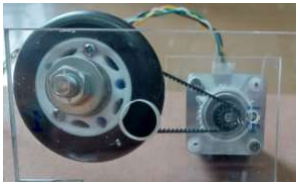
[picture p24: figure]

รูปที่ 4-3 กลไกการทดที่ออกแบบส าหรับการใช้งานในล้อขับเคลื่อน

### 4.1.3 กลไกการเติมน ้าหมึก

ส าหรับการใช้พู่กันในการวาดภาพนั้นมีความจ าเป็นในการเติมน ้าหมึกแต ่เนื่องจากว ่าตัว กระดานนั้นมีการขยับตลอดเวลาท าให้ไม่สามารถวางที่เติมหมึกไว้ได้ผู้จัดท าจึงออกแบบระบบการเติม หมึกโดยใช้ RC Servo Motor ในการช ่วยหมุนแขนถ้วยน ้าหมึกเพื ่อให้สามารถจุ ่มพู ่กันได้โดยมี ลักษณะดังรูปที่ 4-4

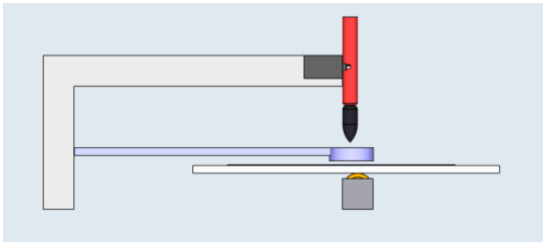
[picture p25: figure]

รูปที่ 4-4 กลไกการเติมน ้าหมึก

### 4.2 ระบบอิเล็กทรอนิกส์

### 4.2.1 กล่องควบคุม

กล่องควบคุมการท างานของระบบที่ประกอบด้วย หน้าจอแอลซีดี ปุ่มตัวเลข และปุ่มกดน าทางทิศ ต่าง ๆ เพื่อใช้ส าหรับป้อนข้อมูลให้ซอฟต์แวร์ควบคุมการท างานของระบบ

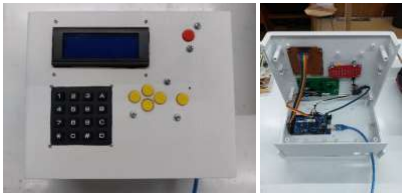
[picture p26: figure]

รูปที่ 4-5 ภาพถ่ายกล่องควบคุม

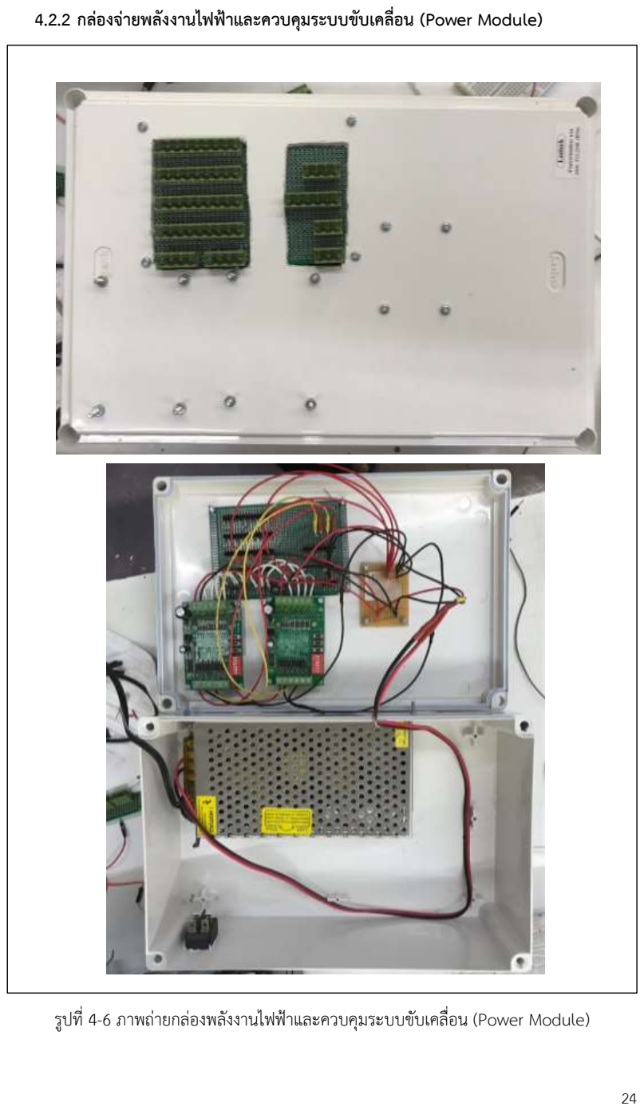
[picture p27: page 36]

### 4.2.2 กล่องจ่ายพลังงานไฟฟ้าและควบคุมระบบขับเคลื่อน (Power Module)

รูปที่ 4-6 ภาพถ่ายกล่องพลังงานไฟฟ้าและควบคุมระบบขับเคลื่อน (Power Module)

### 4.2.3 ชุดสายเชื่อมต่อระหว่างอุปกรณ์

เพื่อความสะดวกในการเคลื่อนย้ายผู้จัดท าจึงท าชุดสายเชื่อมต่อที่สามารถถอดแยกได้โดยมีชนิดหัวต่อ ทั้งสองฝั่งส าหรับเชื่อมต่อระหว่างกล่องและใช้หัวต่อชนิดเดียวกันในการเชื่อมต่อกับอุปกรณ์แต่ละส่วน ซึ่งมีลักษณะดัง

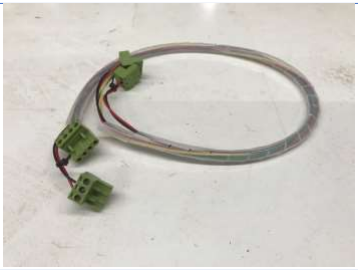
[picture p28: figure]

รูปที่ 4-7 ชุดสายเชื่อมต่อระหว่างอุปกรณ์

### 4.2.4 อุปกรณ์ทดสอบสายเชื่อมต่อ

เนื่องจากการใช้สายเชื่อมต่อนั้นมีความเสี่ยงที่สายอาจมีการช ารุดภายในได้ ผู้จัดท าจึงได้ท าอุปกรณ์ ส าหรับใช้ในการทดสอบการส่งสัญญานในสายเชื่อมต่อเพื่อตรวจสอบความถูกต้องในการใช้งานโดยมี ลักษณะดังรูปที่ 4 7

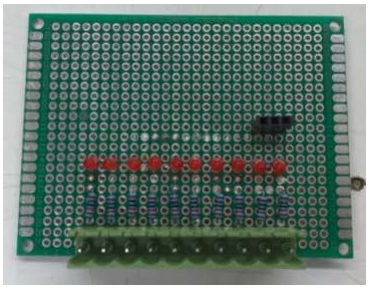
[picture p29: figure]

รูปที่ 4-8 ภาพถ่ายอุปกรณ์ทดสอบสายเชื่อมต่อ

### 4.3 ซอฟต์แวร์และอัลกอริทึม

### 4.3.1 ฟังก์ชันพื้นฐานในการเคลื่อนที่

ระบบที่ถูกออกแบบได้ก าหนดให้ใช้แนวแกน Y เป็นแกนหลักในการเคลื่อนที่ โดยหากต้องการที่ เคลื่อนที่ในแนวแกนอื่นเราจะใช้การrotateในการหมุนเพื่อเปลี่ยนแกนในการเคลื่อนที่ โดยจะได้ รูปแบบพื้นฐานทั้งหมด 4 รูปแบบดังนี้

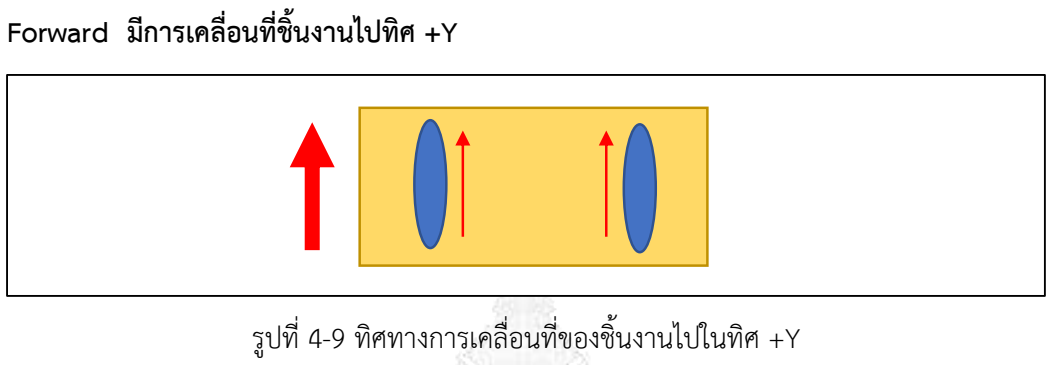
[picture p30: figure]
Forward มีการเคลื่อนที่ชิ้นงานไปทิศ +Y; รูปที่ 4-9 ทิศทางการเคลื่อนที่ของชิ้นงานไปในทิศ +Y
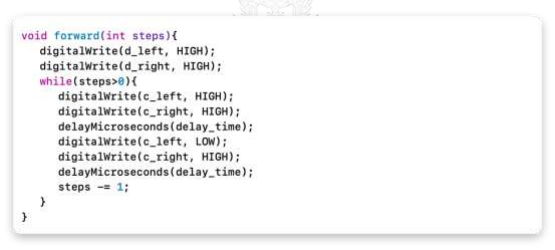
[picture p31: figure]

รูปที่ 4-10 ค าสั่งควบคุมการเคลื่อนที่ชิ้นงานไปในทิศ +Y

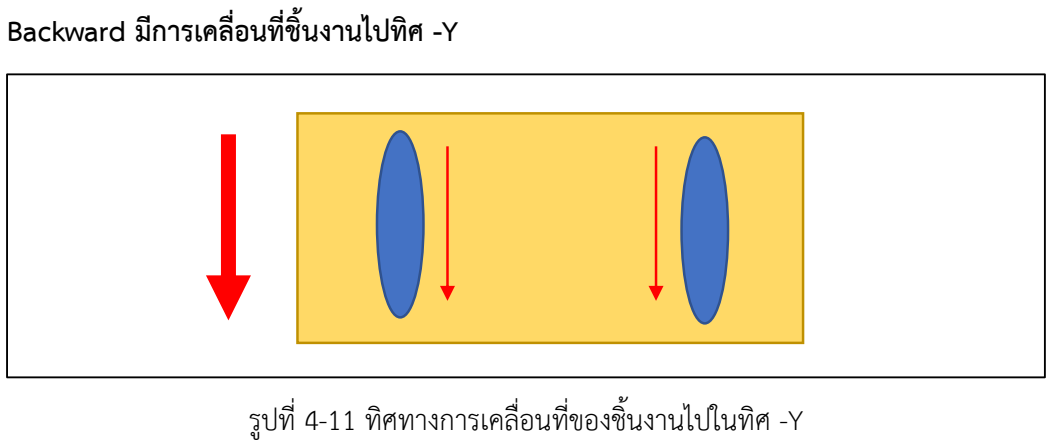
[picture p32: figure]
Backward มีการเคลื่อนที่ชิ้นงานไปทิศ -Y; รูปที่ 4-11 ทิศทางการเคลื่อนที่ของชิ้นงานไปในทิศ -Y
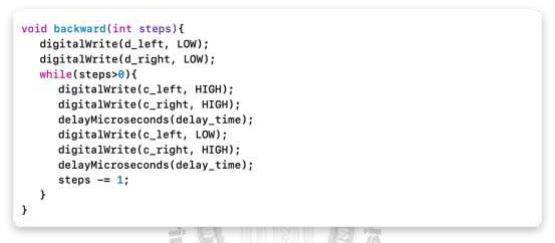
[picture p33: figure]

รูปที่ 4-12 ค าสั่งควบคุมการเคลื่อนที่ชิ้นงานไปในทิศ -Y

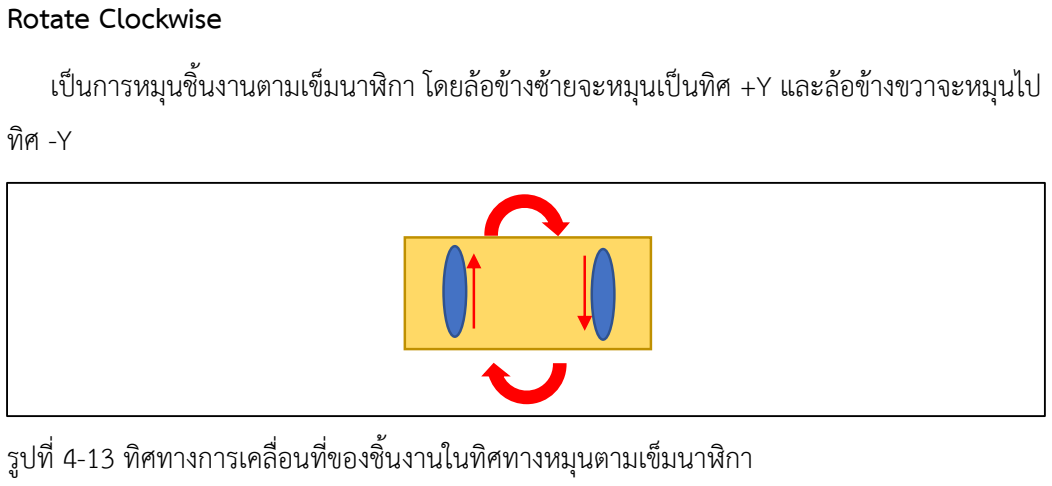
[picture p34: figure]
Rotate Clockwise; เป็นการหมุนชิ้นงานตามเข็มนาฬิกา โดยล้อข้างซ้ายจะหมุนเป็นทิศ +Y และล้อข้างขวาจะหมุนไป ทิศ -Y; รูปที่ 4-13 ทิศทางการเคลื่อนที่ของชิ้นงานในทิศทางหมุนตามเข็มนาฬิกา
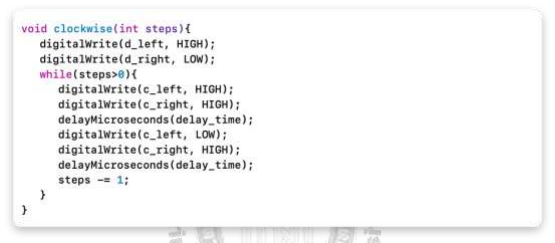
[picture p35: figure]

รูปที่ 4-14 ค าสั่งควบคุมทิศทางการเคลื่อนที่ของชิ้นงานในทิศทางหมุนตามเข็มนาฬิกา

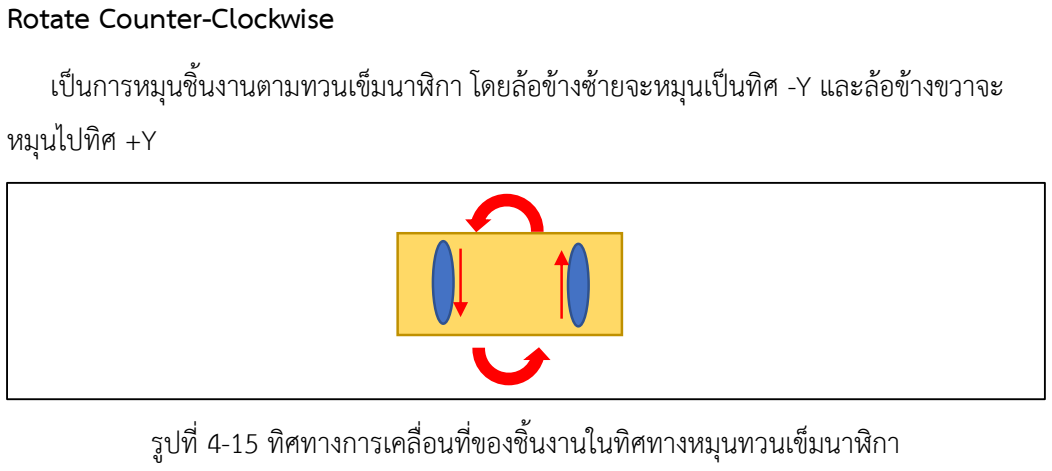
[picture p36: figure]
Rotate Counter-Clockwise; เป็นการหมุนชิ้นงานตามทวนเข็มนาฬิกา โดยล้อข้างซ้ายจะหมุนเป็นทิศ -Y และล้อข้างขวาจะ หมุนไปทิศ +Y; รูปที่ 4-15 ทิศทางการเคลื่อนที่ของชิ้นงานในทิศทางหมุนทวนเข็มนาฬิกา
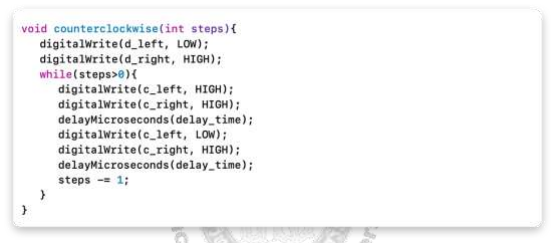
[picture p37: figure]

รูปที่ 4-16 ค าสั่งควบคุมทิศทางการเคลื่อนที่ของชิ้นงานในทิศทางหมุนทวนเข็มนาฬิกา

### 4.3.2 ฟังก์ชันการควบคุมการท างานของกล่องควบคุม

1. การแสดงผลจอ LCD แบบ I2C

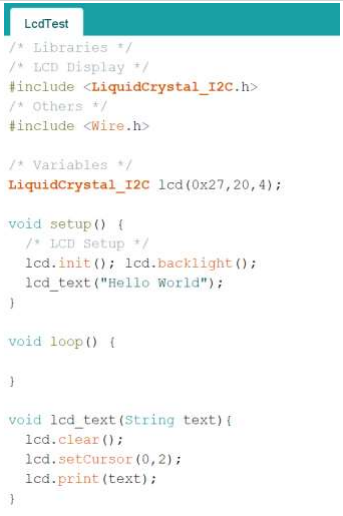
[picture p38: figure]

รูปที่ 4-17 ค าสั่งที่ใช้ในการควบคุมการแสดงผลของจอ LCD แบบ I2C

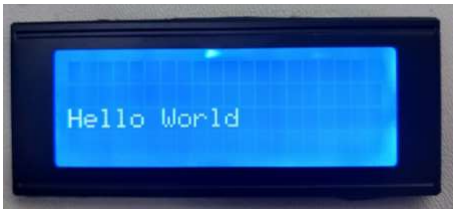
[picture p39: figure]

รูปที่ 4-18 ผลลัพธ์ของการท างานตามค าสั่งใน รูปที่ 4-17

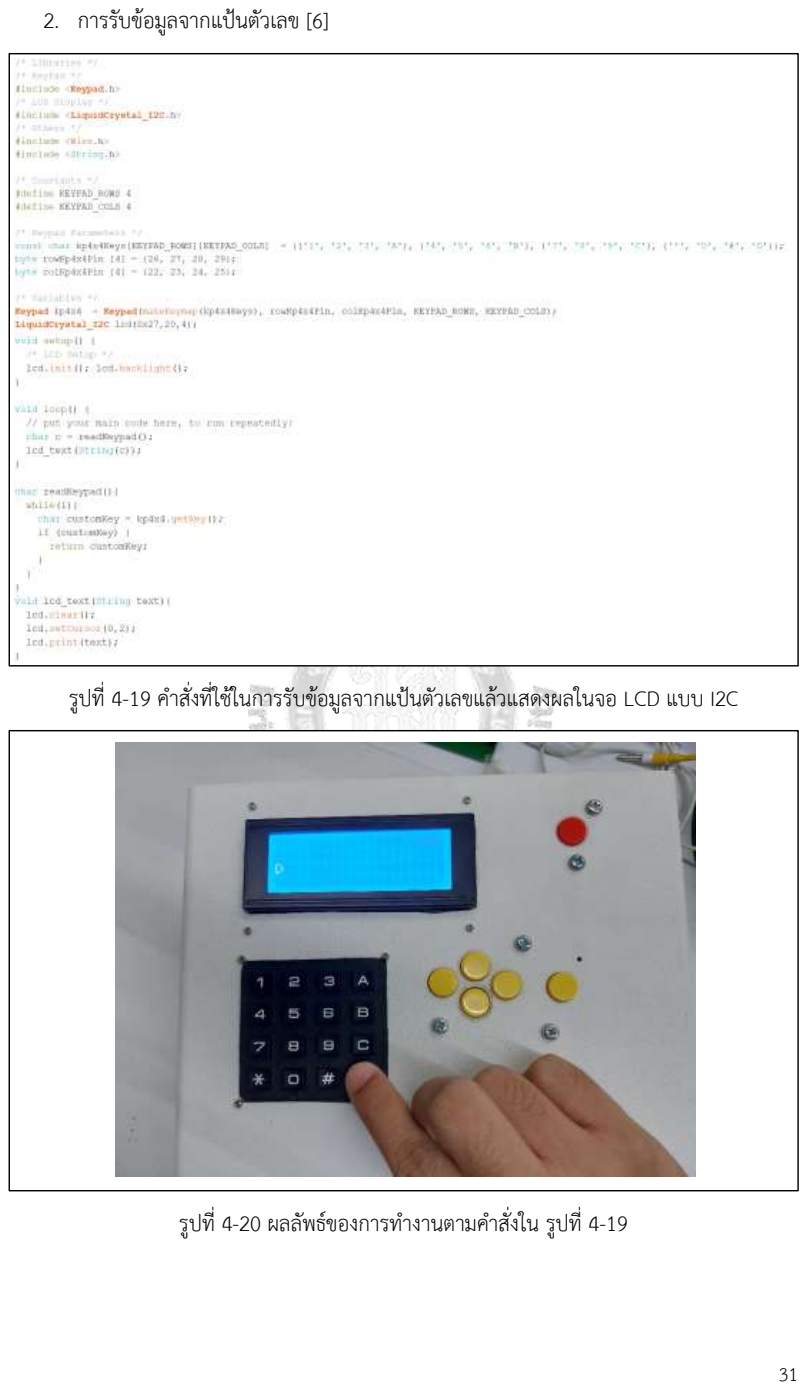
[picture p40: page 43]

2. การรับข้อมูลจากแป้นตัวเลข [6]

รูปที่ 4-19 ค าสั่งที่ใช้ในการรับข้อมูลจากแป้นตัวเลขแล้วแสดงผลในจอ LCD แบบ I2C

รูปที่ 4-20 ผลลัพธ์ของการท างานตามค าสั่งใน รูปที่ 4-19

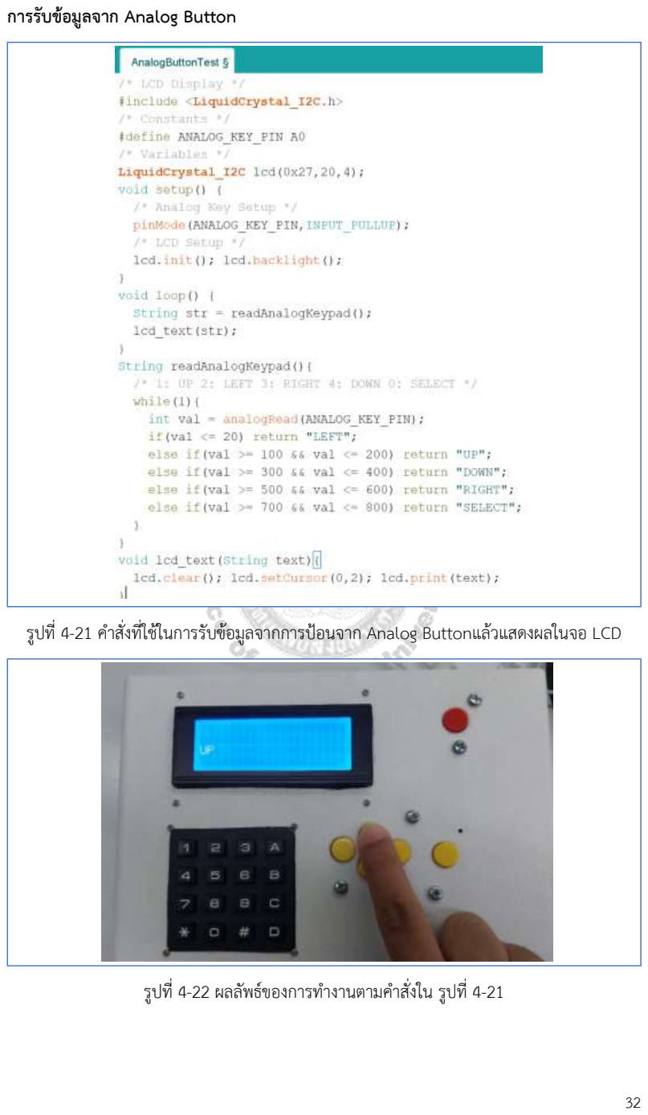
[picture p41: page 44]

การรับข้อมูลจาก Analog Button

รูปที่ 4-21 ค าสั่งที่ใช้ในการรับข้อมูลจากการป้อนจาก Analog Buttonแล้วแสดงผลในจอ LCD

รูปที่ 4-22 ผลลัพธ์ของการท างานตามค าสั่งใน รูปที่ 4-21

3. ฟังก์ชันการควบคุมการท างานของ RC Servo Motor [7]

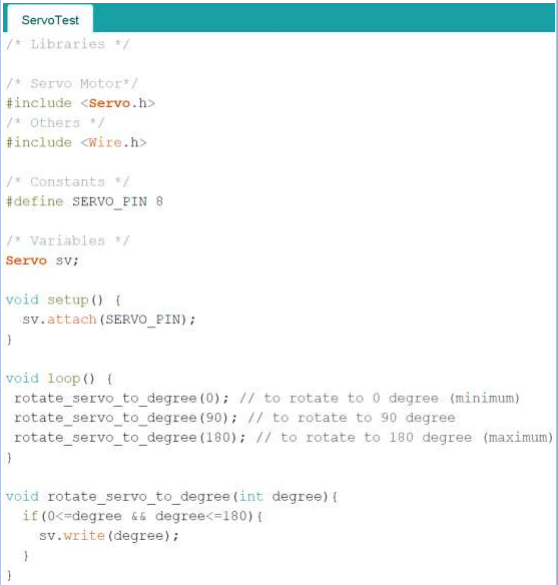
[picture p42: figure]

รูปที่ 4-23 ค าสั่งที่ใช้ในการควบคุม RC Servo Motor ให้ไปยังต าแหน่งองศาต่าง ๆ

4. ฟังก์ชันแสดงผลหน้าจอเมนู

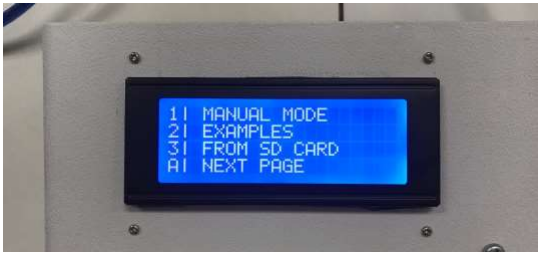
[picture p43: figure]

รูปที่ 4-24 ภาพถ่ายการแสดงผลตามฟังก์ชันแสดงผลหน้าจอเมนู void menu(int page_number){ if(page_number==1){
lcd.clear();
lcd.setCursor(0,0);
lcd.print("1| MANUAL MODE"); lcd.setCursor(0,1);
lcd.print("2| EXAMPLES");
lcd.setCursor(0,2);
lcd.print("3| FROM SD CARD"); lcd.setCursor(0,3);
lcd.print("A| NEXT PAGE"); }else if(page_number==2){
lcd.clear();
lcd.setCursor(0,0);
lcd.print("4| -");
lcd.setCursor(0,1);
lcd.print("5| -");
lcd.setCursor(0,2);
lcd.print("6| -");
lcd.setCursor(0,3);
lcd.print("A| NEXT PAGE"); }
}

5. ฟังก์ชันแสดงผลหน้าจอควบคุมการท างานแบบก าหนดเอง

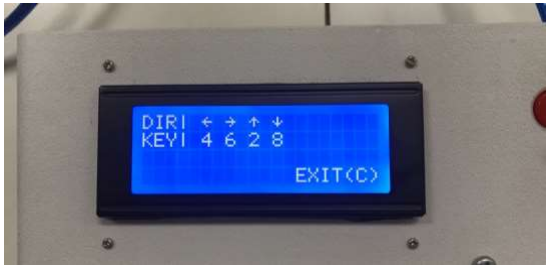
[picture p44: figure]

รูปที่ 4-25 ภาพถ่ายการแสดงผลตามฟังก์ชันแสดงผลหน้าจอควบคุมการท างานแบบก าหนดเอง

void show_manual_guide(){
lcd.clear();
lcd.setCursor(0,0);
lcd.print("DIR|");
lcd.setCursor(0,1);
lcd.print("KEY|");
lcd.setCursor(5,0); lcd.write(byte(1)); lcd.setCursor(7,0); lcd.write(byte(2)); lcd.setCursor(9,0); lcd.write(byte(3)); lcd.setCursor(11,0); lcd.write(byte(4)); lcd.setCursor(5,1); lcd.print("4"); lcd.setCursor(7,1); lcd.print("6"); lcd.setCursor(9,1); lcd.print("2"); lcd.setCursor(11,1); lcd.print("8"); lcd.setCursor(13,3); lcd.print("EXIT(C)"); }

### 4.3.3 ฟังก์ชันการตั้งศูนย์

เนื่องจากระบบมีความเป็นไปได้ที่จะเกิดค่าความผิดพลาดเล็กน้อยซึ่งยอมรับได้แต่เมื่อปล่อยไว้จะ สะสมจนเกินที่รับได้จึงต้องมีการหาศูนย์เพื่อลดความผิดพลาดสะสมของระบบ แล้วค่อยกลับไป ท างานต่อโดยมีหลักการดังนี้
โปรแกรมจะคอยนับจ านวนค าสั่งหรือจ านวนรอบเมื่อถึงที่ก าหนดเริ่มท าการหาศูนย์ เช็คว่าปัจจุบันอยู่จุดใดของกระดาน เลื่อนปรับมุมจนเส้นที่ใช้เป็นตัวยึดกึ่งกลางของกระดานอยู่ในจุดที่เป็นจุดศูนย์ เลื่อนกลับไปยังจุดและมุมที่เก็บไว้ก่อนที่จะหาศูนย์แล้วท างานต่อไป

### 4.3.4 ฟังก์ชันจดจ าต าแหน่ง

เนื่องจากว่าเพื่อความสะดวกหลังการหาศูนย์แล้วมีความจ าเป็นต้องท างานต่อจึงต้องมีการ จดจ าจุดที่ท างานล่าสุดก่อนหาศูนย์เพื่อกลับไปยังจุดล่าสุดที่อยู่โดยข้อมูลจะเก็บไว้ที่โครงสร้างข้อมูลที่ เก็บข้อมูลไว้3 ข้อมูล คือ มุมที่หมุนไป พิกัดในแกน x พิกัดในแกน y โดยจะตั้งให้จุดกึ่งกลางเป็นพิกัด (0,0) และเก็บมุมที่มีขนาดตั้งแต่ 0 ถึง 360 องศา

### 4.3.5 เมนูควบคุมการท างานของระบบ

ในการท างานของระบบจะมีการแสดงเมนูในหน้าจอแสดงผลเพื่อรอรับค าสั่งจากผู้ใช้โดยมี เมนูใช้งาน 3 โหมด คือ
- โหมดการควบคุมการท างานแบบก าหนดเอง
- โหมดตัวอย่าง (รูปเรขาคณิตพื้นฐาน)
- โหมดวาดภาพโดยน าเข้าข้อมูลจาก SD Card

### 4.3.6 การแปลงข้อมูลภาพวาดเป็นชุดข้อมูลรูปแบบ G-Code

ในการแปลงข้อมูลภาพวาดที่อยู่ในรูปแบบไฟล์ภาพจะต้องใช้โปรแกรม Inkscape ในการจัดการ แปลงข้อมูลภาพเป็นข้อมูลในรูปแบบ G-Code ซึ่งมีขั้นตอนดังนี้
1. หลังจากเปิดโปรแกรมและน าเข้ารูปภาพที่ต้องการแล้วเลือก Path > Trace Bitmap…

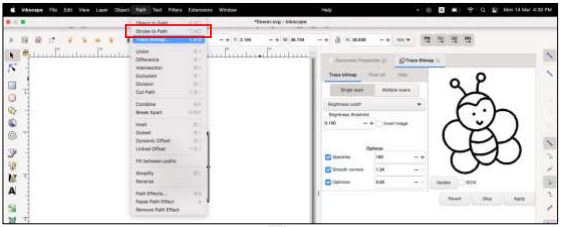
[picture p45: figure]

รูปที่ 4-26 ขั้นตอนที่ 1 ของการแปลงรูปภาพเป็น G-Code
2. เลือก Update และเลือก Apply

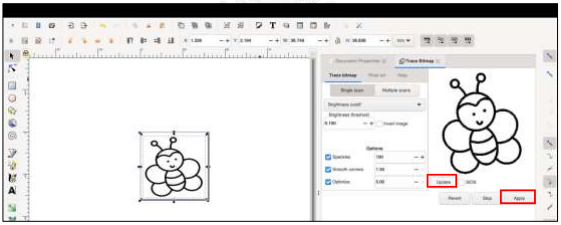
[picture p46: figure]

รูปที่ 4-27 ขั้นตอนที่ 2 ของการแปลงรูปภาพเป็น G-Code

3. เลือก Extensions > Gcodetools > Path to Gcode…

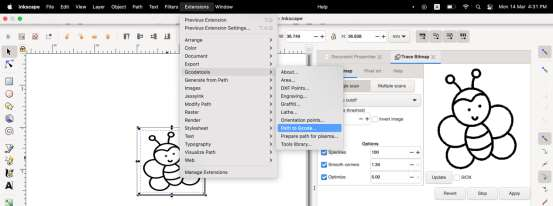
[picture p47: figure]

รูปที่ 4-28 ขั้นตอนที่ 3 ของการแปลงรูปภาพเป็น G-Code
4. จากนั้นเลือกแฟ้มที่ต้องการบันทึก และกดบันทึก

### 4.3.7 ซอฟต์แวร์แปลง GCode เป็นชุดข้อมูลพิกัดการวาดอย่างง่าย

เนื่องจากในการวาดภาพในโครงงานนี้ใช้ระบบพิกัดที่มีความแตกต่างกันกับระบบพิกัดที่ได้จาก GCode จึงจะต้องมีการแปลงข้อมูลซ ้าอีกครั้งเพื่อน าไปใช้งาน ซึ่งมีการกรองค่าที่ไม่จ าเป็นที่ได้จาก การแปลงรูปภาพเป็น GCode ออกไปด้วย

### 4.3.8 ซอฟต์แวร์ส าหรับการจ าลองการวาดภาพ

เพื่อเป็นการตรวจสอบผลการแปลงรูปภาพเป็น GCode ผู้จัดท าจึงได้พัฒนาซอฟต์แวร์ส าหรับ จ าลองภาพวาดผลลัพธ์ที่จะได้โดยใช้Flutter ในการพัฒนาและเผยแพร่ให้ใช้งานในรูปแบบเว็บ (ลิงค์: https://drawing-tools-akarapon.web.app/ ) ซึ่งได้รวมซอฟต์แวร์แปลง GCode เป็นชุด ข้อมูลพิกัดการวาดอย่างง่ายไว้ในเว็บไซต์ดังกล่าวด้วย

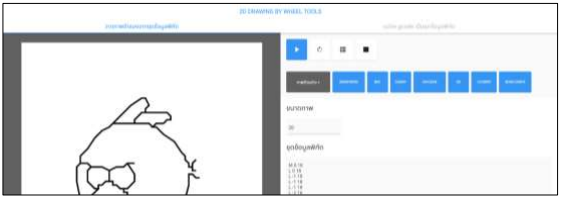
[picture p48: figure]

รูปที่ 4-29 หน้าเว็บไซต์ส าหรับการจ าลองการวาดภาพ

### 4.4 ผลการทดสอบ

ความก้าวหน้าในระยะที ่ 3 นี้จะมุ ่งเน้นไปที ่การออกแบบและพัฒนาอัลกอริทึมและระบบ อิเล็กทรอนิกส์ที ่ใช้ในการควบคุมการท างานของอุปกรณ์ฮาร์ดแวร์เป็นหลักโดยมีรายละเอียด ความก้าวหน้าดังนี้

### 4.4.1 ผลการแปลงรูปภาพเป็น GCode

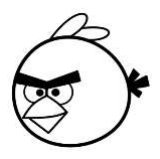
[picture p49: figure]
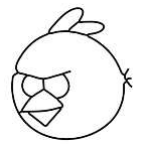
[picture p50: figure]

รูปที่ 4-30 ผลการใช้ฟังก์ชัน Trace Bitmap... บนโปรแกรม Inkscape

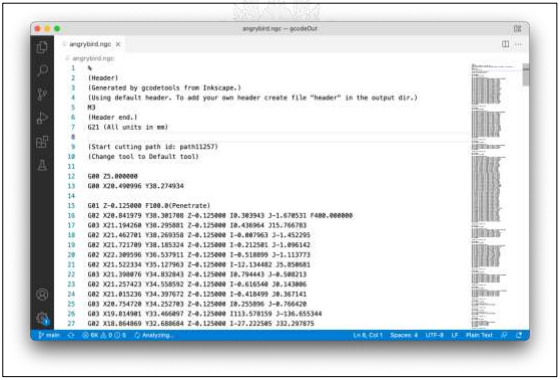
[picture p51: figure]

รูปที่ 4-31 GCode ที่ได้จากการแปลงจากรูป 4 3

### 4.4.2 ผลการแปลงข้อมูลในรูปแบบ GCode เป็นชุดข้อมูลพิกัดการวาดอย่างง่าย

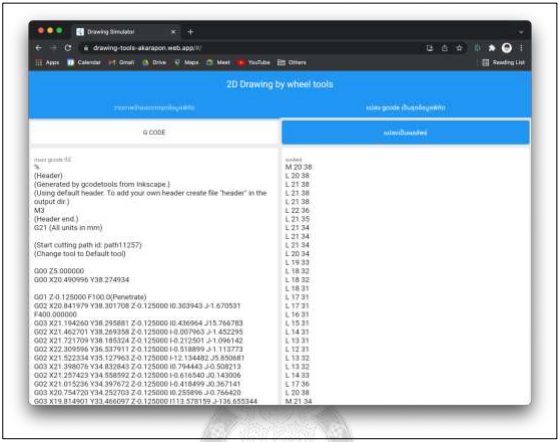
[picture p52: figure]

รูปที่ 4-32 ผลการแปลงข้อมูลในรูปแบบ GCode เป็นชุดข้อมูลพิกัดการวาดอย่างง่าย

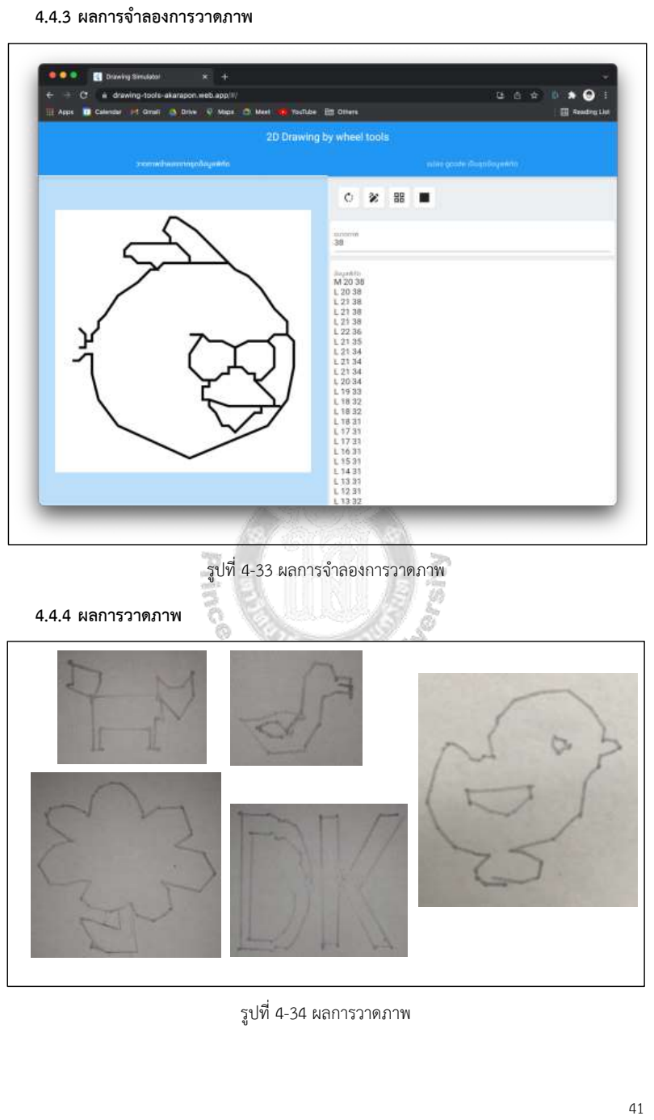
[picture p53: page 53]

### 4.4.3 ผลการจ าลองการวาดภาพ

รูปที่ 4-33 ผลการจ าลองการวาดภาพ

### 4.4.4 ผลการวาดภาพ

รูปที่ 4-34 ผลการวาดภาพ

บทที่5 สรุป

### 5.1 สรุป

จากการศึกษาการท างานและออกแบบหุ ่นยนต์วาดภาพ 2 มิติโดยการขับเคลื ่อนด้วยล้อ สามารถพัฒนาระบบให้มีความสามารถในการเคลื่อนที่ไปยังพิกัดที่ต้องการได้ ซึ่งสามารถวาดภาพ 2 มิติ โดยระบุค่าพิกัดโดยตรงได้
ชุดกลไกวาดภาพที่พัฒนาขึ้นนี้สามารถรับค าสั่งที่ถูกควบควบคุมผ่านกล่องควบคุมโดยจะมี LCD-Display แสดงหน้าจอ Interface โหมดการท างานต่าง ๆ ให้เลือกท างานพร้อมทั้งปุ่มควบคุม โดยสามารถท างานได้ตามโหมดต่าง ๆ ที่ระบุไว้ เช่น สามารถควบคุมให้เคลื่อนที่ไปยังจุดปลายการ ท างานไปยังพิกัด (0,0) ได้โดยอัตโนมัติ , โหมด Manual ที่สามารถควบคุมส่วนการเคลื่อนที่ไปยัง พิกัดต่าง ๆ บนจุดท างาน โดยมีJoystick เป็นอุปกรณ์ควบคุม , โหมด Test sample จะควบคุมแขน หุ่นยนต์ให้ท าการวาดรูปเรขาคณิตอย่างง่ายที่ได้จากการระบุค่าพิกัดซึ่งสามารถใช้เป็นต้นแบบส าหรับ การพัฒนาต่อได้ในอนาคต

### 5.2 ปัญหาและอุปสรรค

### 5.2.1 งบประมาณในการจัดท าโครงงาน

### 5.2.2 สถานการณ์การแพร่ระบาดของเชื้อไวรัสโควิด 19

ท าให้ไม่สามารถเข้าใช้พื้นที่ห้องปฏิบัติการอย่างต่อเนื่องได้ท าให้เป็นอุปสรรคในการด าเนินงาน

### 5.2.3 เมื่อเกิดการหมุนเป็นเวลานานจะต้องมีการตั้งศูนย์ใหม่

เนื่องจากกลไกในการแก้ไขความผิดพลาดของการท างาน ผู้จัดท าก าหนดให้ต้องมีการตั้งศูนย์ใหม่ ซึ่งกระบวนการนี้จะต้องใช้มือในการปรับหมุนเพื่อตั้งศูนย์ของปากกา

### 5.2.4 การขาดความช านาญในการใช้เครื่องมือช่าง

เช่น สว่าน หัวแร้งและอื่น ๆ ซึ่งท าให้เกิดความล่าช้าในการท างานเนื่องจากต้องเรียนรู้วิธีการใช้ งานเครื่องมือก่อนท างาน

บรรณานุกรม
[1] Kamolc. (2021, Jan 15). แขนหุ่นยนต์[Online].Available: https://www.thairobotics.com/2014/01/10/byob-robot-arm/
[2] MEGAN RAY NICHOLS (2021, Jan 16)Which Industrial Robot Design Is Right for You?[Online].Available:
https://www.eeworldonline.com/which-industrial-robot-design-is-right-for-you/
[3] gravitechthai.com. (2021, Jan 15). Arduino Mega2560[Online].Available: https://www.gravitechthai.com/product-detail.php?WP=qmIZAJ1CM5O0hJatrTZo7o3Q
[4] thaieasyelec.com.( 2021, Jan 15).บทความ "ตัวอย่างการควบคุม RC Servo Motor ด้วย Arduino”[Online].Available: https://www.thaieasyelec.com/article-wiki/review-productarticle/Example-project-how-to-control-rc-servo-motor-with-arduino.html
[5] factomart.com. (2021, Jan 15).ประเภทของ Stepping Motor[online].Available: https://mall.factomart.com/type-of-stepping-motor/
[6] thaiio.com. (2021, Jan 15). ความรู้เบื้องต้น และ หลักการท างาน Step Moter ตอน ที่1[Online].Available:
http://www.thaiio.com/Hardware/stepmoter.htm
[7] ] factomart.com. (2021, Jan 15).บทความ” Stepping Motor Drive คืออะไร?” [online].Available:
https://mall.factomart.com/what-is-stepping-motor-drive/
[8] ] know2learning.blogspot.com. (2021, Jan 15). การใช้งานแป้นปุ่มกด (Keypad) แบบ 4x4 ปุ่ม [Online]. Available: http://know2learning.blogspot.com/2017/02/keypad-4x4.html
[9] ioxhop.com. (2021, Jan 15). การใช้งานจอ Character LCD กับ Arduino แบบละเอียด [Online].Available: https://www.ioxhop.com/article/
[10] arduinoall.com.( 2021, Jan 15).Arduino สอนการใช้งาน จอยสติ๊ก PS2 joy[Online].Available: https://www.arduinoall.com/article/307/71-arduino-%E0%B8%81-ps2-joy
