akarapon-oaksonsombat/wheel-drive-drawing-robot/how_to_convert_gcode.png

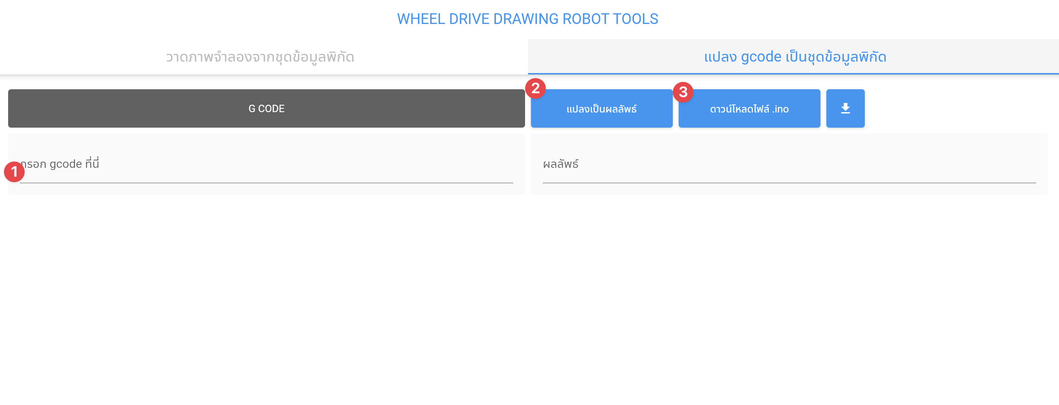
how_to_convert_gcode.png
