akarapon-oaksonsombat/wheel-drive-drawing-robot/how_to_simulate.png

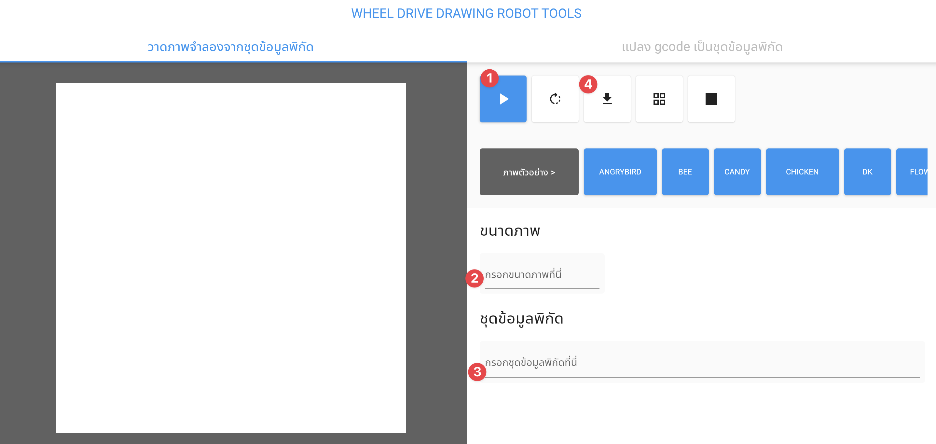
how_to_simulate.png
